Git-Kavinda/2.4GHZ_Patch_Antenna_Design/Readme.md

# 2.4GHz Microstrip Patch Antenna Design

## Project Overview
This repository contains the design files and documentation for a 2.4GHz microstrip patch antenna, developed during an industrial training at Arthur C Clarke Institution for Modern Technologies (ACCIMT). The project demonstrates the implementation of a cost-effective antenna design using readily available materials and basic fabrication techniques.

## Introduction
The design and fabrication of a 2.4GHz microstrip patch antenna was one of the significant projects undertaken during my training period at ACCIMT. Microstrip patch antennas have gained considerable attention in modern wireless communication systems due to their low profile, lightweight nature, ease of integration, and cost-effectiveness. These antennas are extensively used in various applications including Wi-Fi devices and wireless routers (2.4GHz ISM band), IoT (Internet of Things) devices, Military radar systems, and Medical devices.

This project provided valuable hands-on experience in:
- Practical application of microwave engineering principles
- Understanding of antenna parameters and their optimization
- Implementation of cost-effective fabrication techniques
- Testing and measurement using a Vector Network Analyzer (VNA)
- Problem-solving in resource-constrained environments and team collaboration

## Repository Contents
- `/simulation`: Electromagnetic simulation results
- `/documentation`: Project documentation, calculations and reports
- `/measurements`: Test results and VNA measurements
- `/images`: Photos of the fabrication process and final product
- `/PCB_Footprints` : PCB Footprint for 2.4 GHz rectangular patch antenna

## Tools Used
- CST Studio Suite 2019
- Vector Network Analyzer (VNA)
- FR-4 Substrate PCB
- Basic fabrication tools 

## Results
The implemented antenna demonstrated satisfactory performance at 2.4GHz, making it suitable for various wireless applications. Detailed performance metrics and measurements can be found in the documentation section.

## Contributors
- S.A.P. Kavinda https://github.com/Git-Kavinda/
- R M W M Dissanayake https://github.com/wathsala-git

## License
This project is licensed under the MIT License - see the LICENSE.md file for details.

## Images




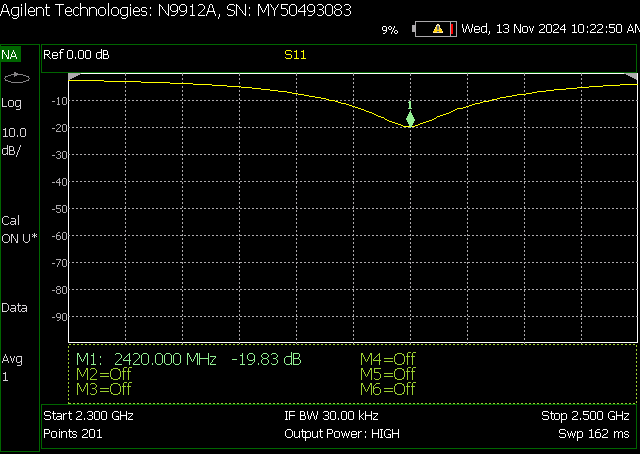
[picture p1: images/Fabrication/log.png]

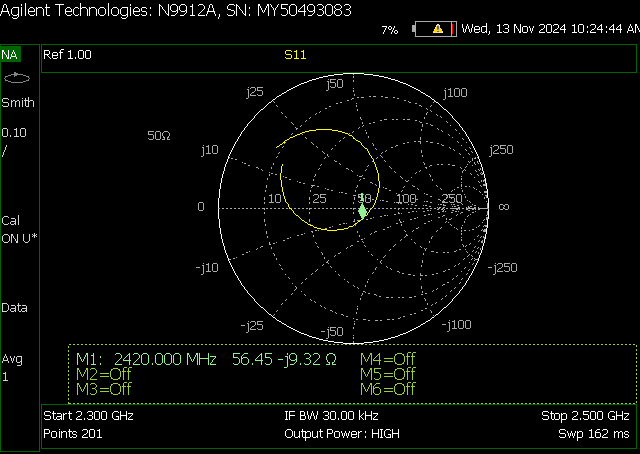
[picture p2: images/Fabrication/smith.png]

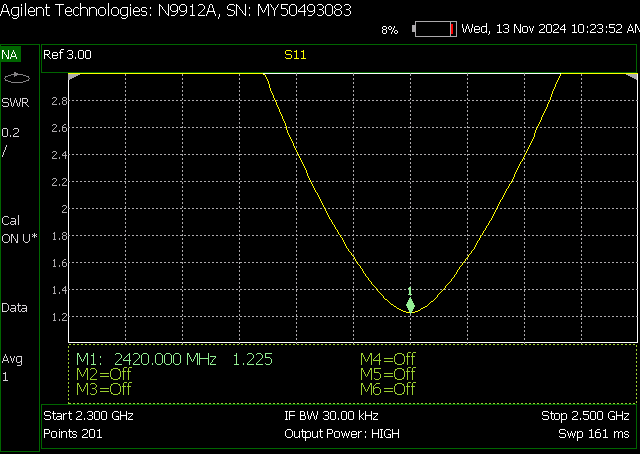
[picture p3: images/Fabrication/VSWR.png]
