Git-Kavinda/2.4GHZ_Patch_Antenna_Design/images/Simulations&Design/1..png

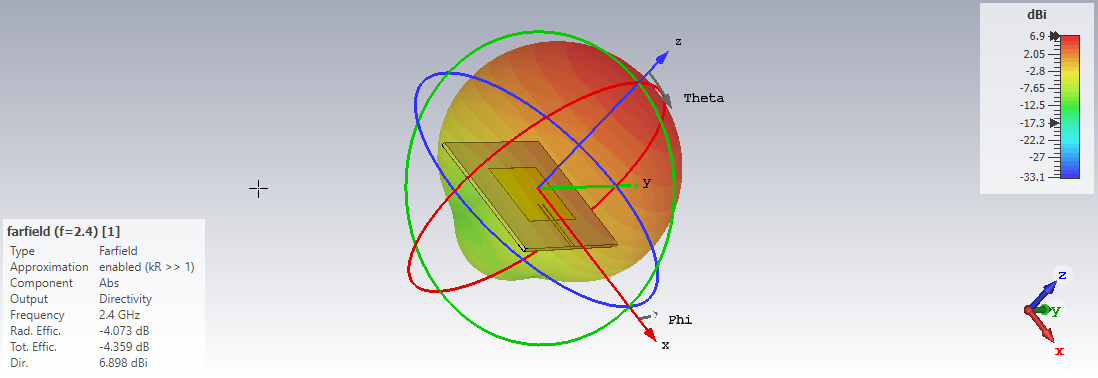
images/Simulations&Design/1..png
