Git-Kavinda/2.4GHZ_Patch_Antenna_Design/images/Simulations&Design/2.png

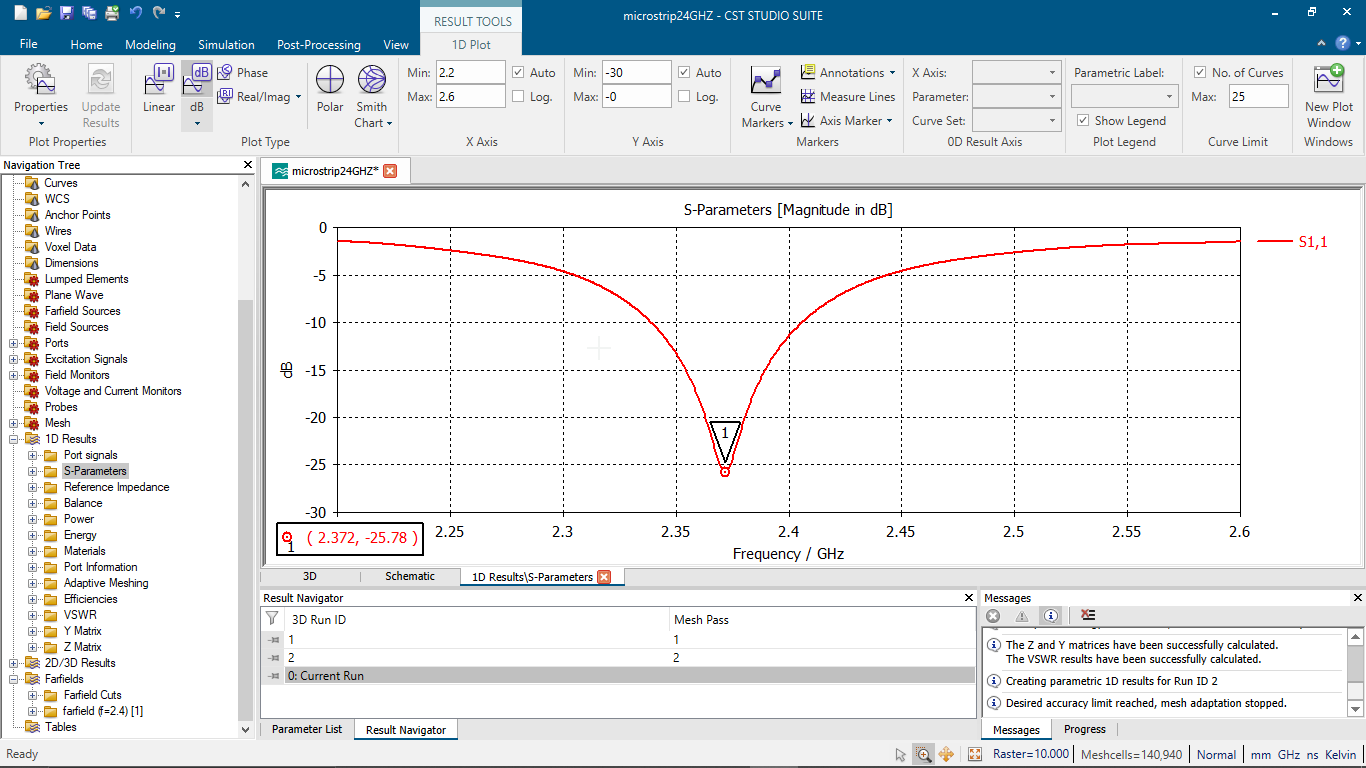
images/Simulations&Design/2.png
