Git-Kavinda/2.4GHZ_Patch_Antenna_Design/images/Simulations&Design/3.png

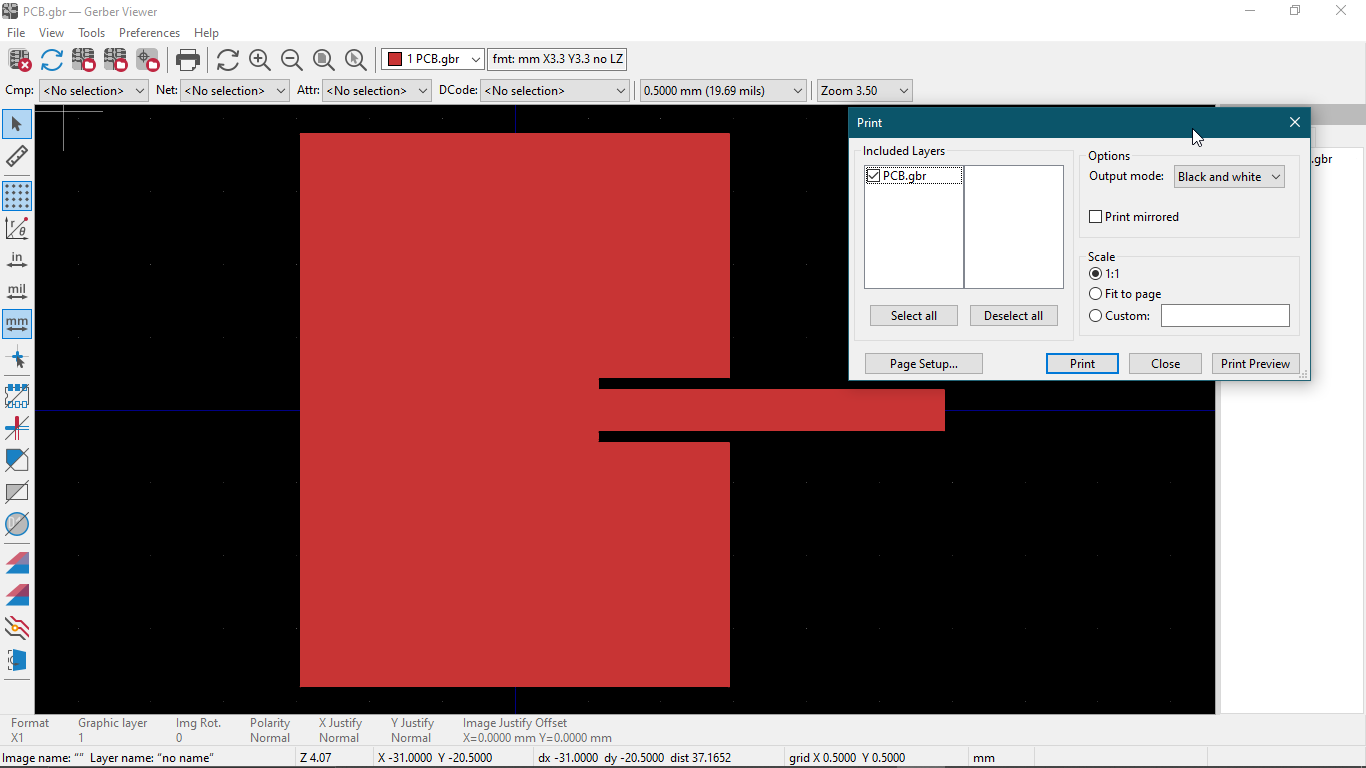
images/Simulations&Design/3.png
