Git-Kavinda/2.4GHZ_Patch_Antenna_Design/images/Simulations&Design/CjnEfZ1jPv.png

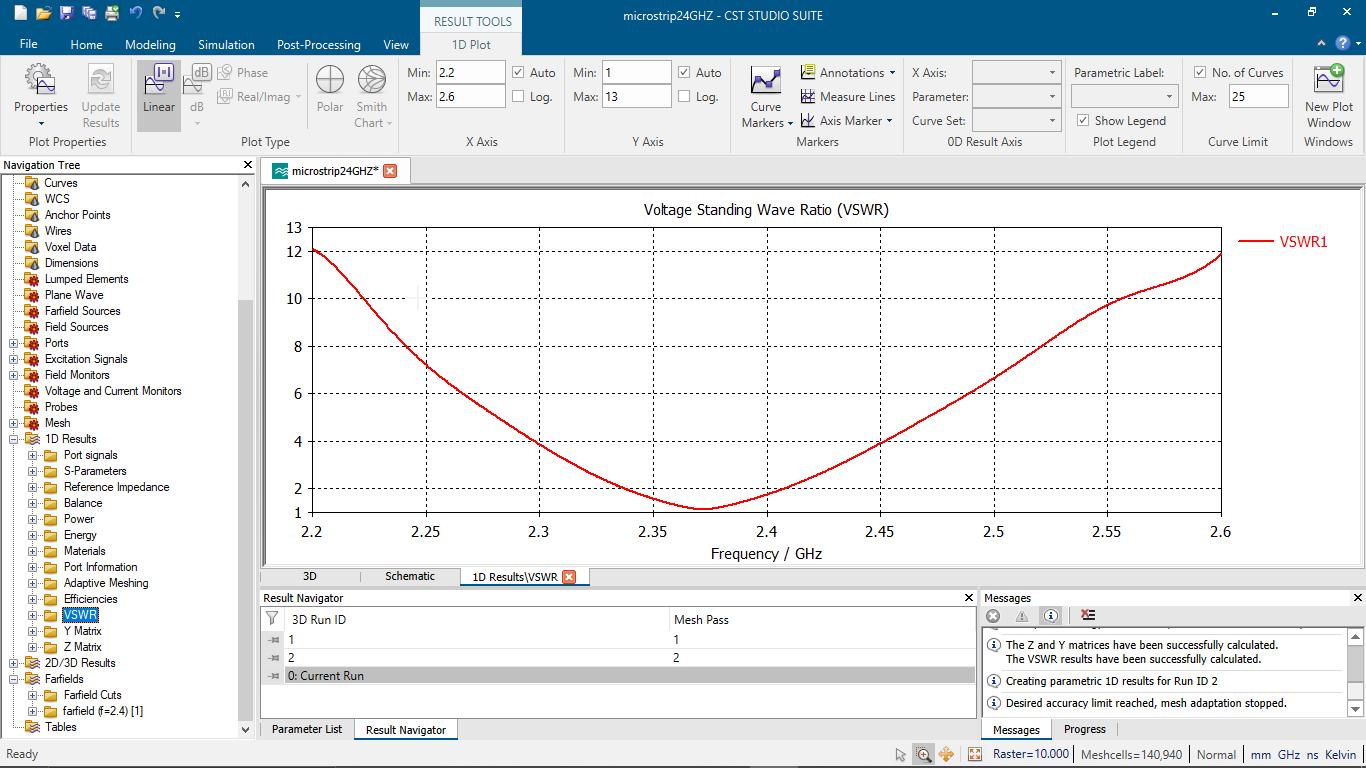
images/Simulations&Design/CjnEfZ1jPv.png
