Git-Kavinda/2.4GHZ_Patch_Antenna_Design/images/Simulations&Design/CST_DESIGN_ENVIRONMENT_AMD64_28ji8Xqdwm.png

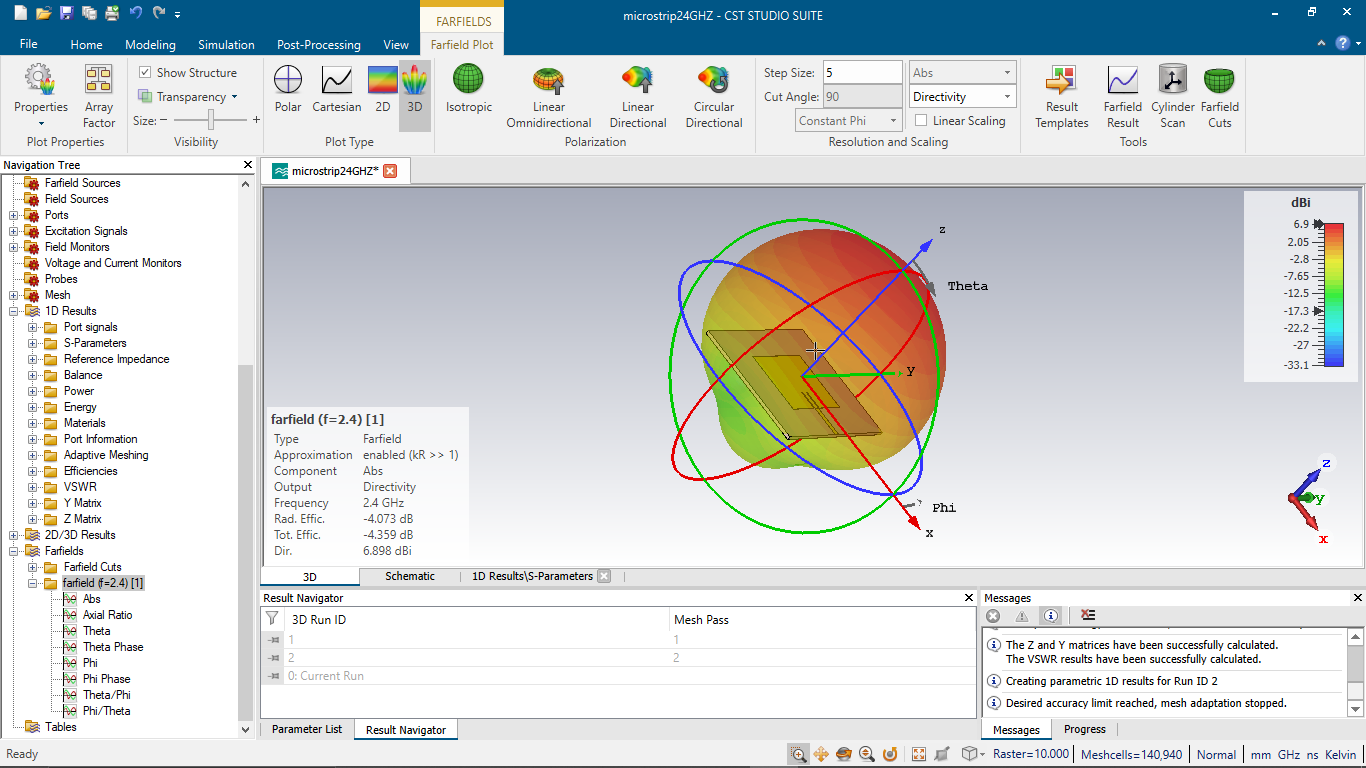
images/Simulations&Design/CST_DESIGN_ENVIRONMENT_AMD64_28ji8Xqdwm.png
