Git-Kavinda/2.4GHZ_Patch_Antenna_Design/simulation/microstrip24GHZ/Temp/clipboard.bmp

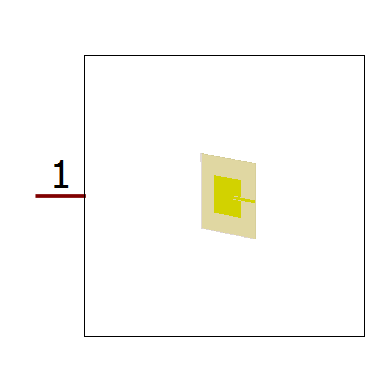
simulation/microstrip24GHZ/Temp/clipboard.bmp
