Git-Kavinda/2.4GHZ_Patch_Antenna_Design/(list of files, cad)

Other CAD files:
simulation/microstrip24GHZ/ModelCache/Model.psm
simulation/microstrip24GHZ/Result/Port1_e1.prt
simulation/microstrip24GHZ/Result/Port1_e1[2.4].prt
simulation/microstrip24GHZ/Result/Port1_h1.prt
simulation/microstrip24GHZ/Result/Port1_h1[2.4].prt
simulation/microstrip24GHZ/Result/adapt_Port1_e1.prt
simulation/microstrip24GHZ/Result/adapt_Port1_e1[2.4].prt
simulation/microstrip24GHZ/Result/adapt_Port1_h1.prt
simulation/microstrip24GHZ/Result/adapt_Port1_h1[2.4].prt
