Git-Kavinda/2.4GHZ_Patch_Antenna_Design/(list of files, drawings)

Other design files:
simulation/microstrip24GHZ/Model/3D/Model.dsn
