Git-Kavinda/2.4GHZ_Patch_Antenna_Design/images/Fabrication and results/WhatsApp Image 2024-11-15 at 13.45.15.jpeg

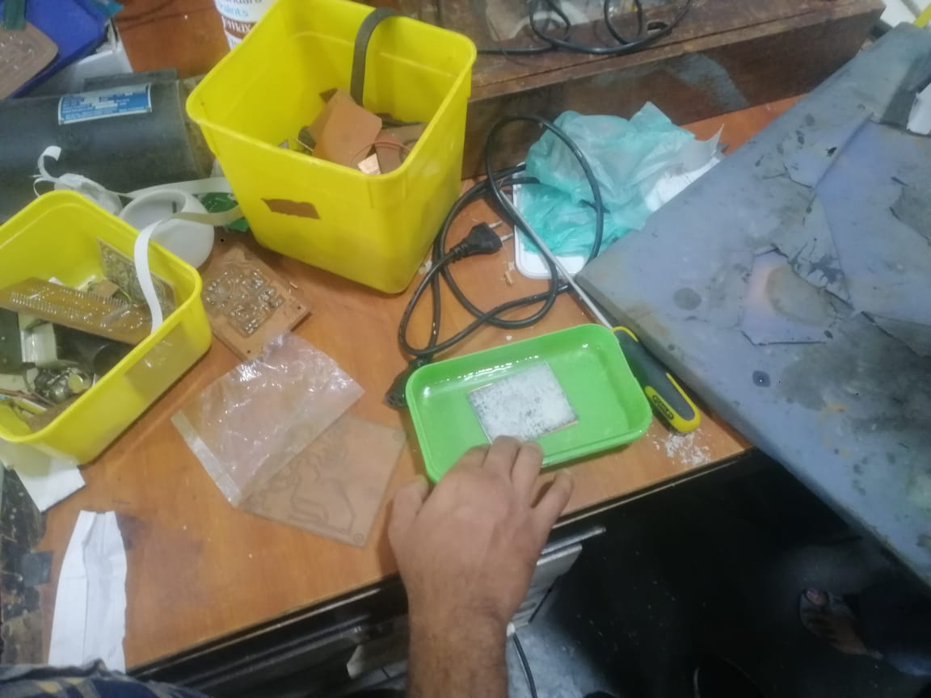
images/Fabrication and results/WhatsApp Image 2024-11-15 at 13.45.15.jpeg
