Git-Kavinda/2.4GHZ_Patch_Antenna_Design/images/Fabrication and results/WhatsApp Image 2024-11-15 at 13.47.22 - Copy.jpeg

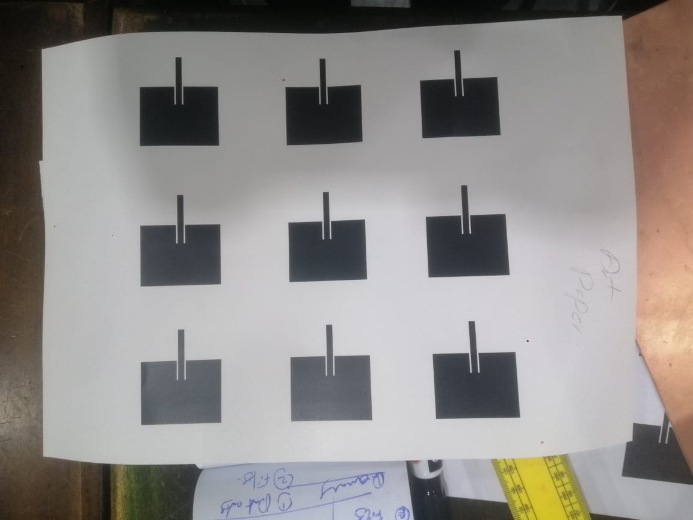
images/Fabrication and results/WhatsApp Image 2024-11-15 at 13.47.22 - Copy.jpeg
