Git-Kavinda/2.4GHZ_Patch_Antenna_Design/images/Fabrication and results/WhatsApp Image 2024-11-15 at 15.11.18 - Copy.jpeg

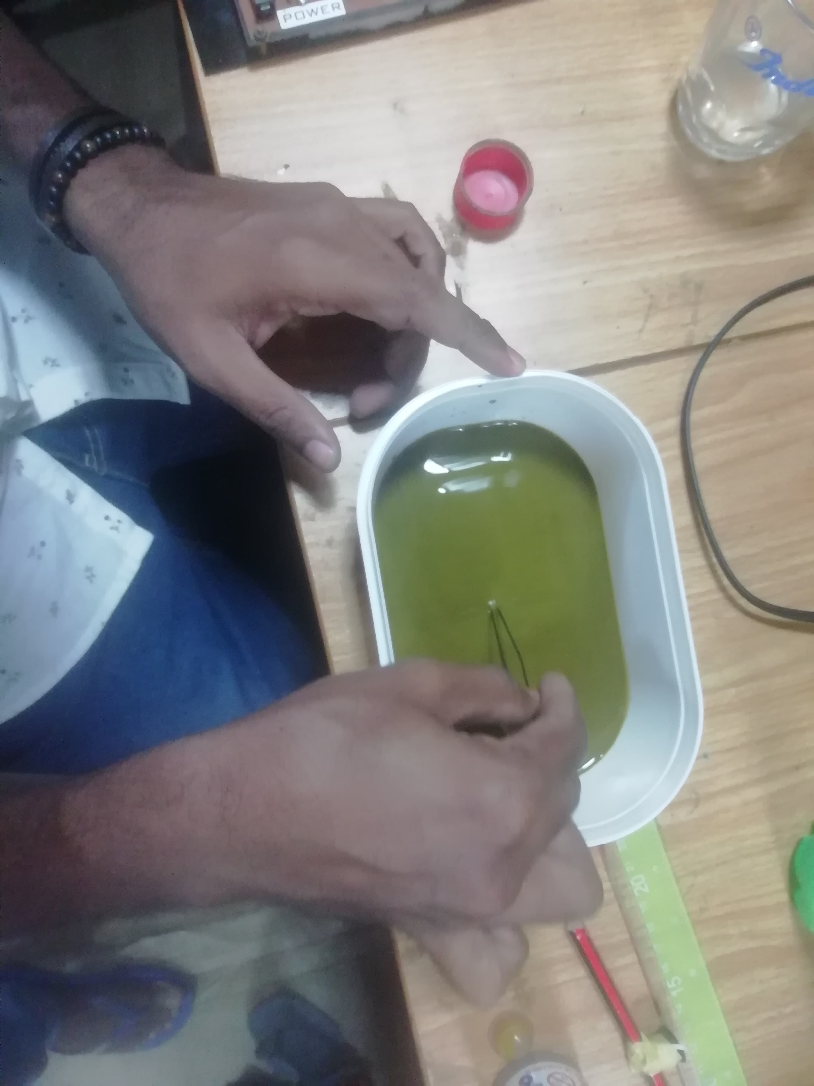
images/Fabrication and results/WhatsApp Image 2024-11-15 at 15.11.18 - Copy.jpeg
