Git-Kavinda/2.4GHZ_Patch_Antenna_Design/(commit log)

2024-11-03 Finalized First Design
    [Model.dsn, Model.psm, Port1_e1.prt, Port1_e1[2.4].prt, Port1_h1.prt, Port1_h1[2.4].prt, adapt_Port1_e1.prt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]
2024-11-03 Add simulation photos and PCB Layout for print
